salt4king/quadruped/cad/stl/thigh_right.stl

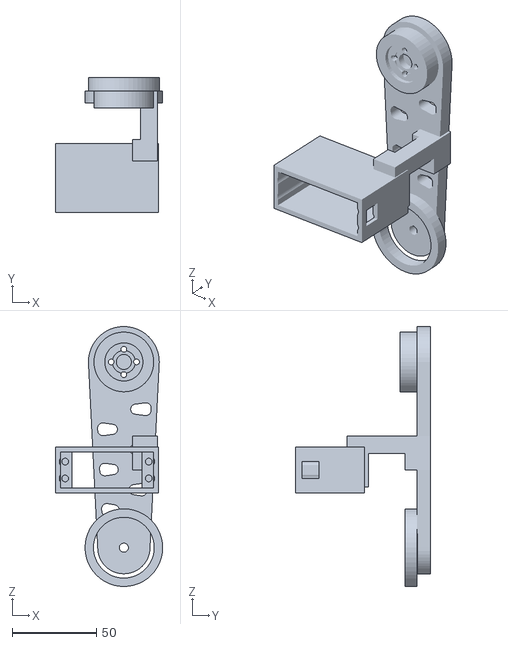
[picture p5: CAD file, 2026-10-24]
cad/stl/thigh_right.stl
63.6 x 80.0 x 154.0
