salt4king/quadruped/cad/web/shank.stl

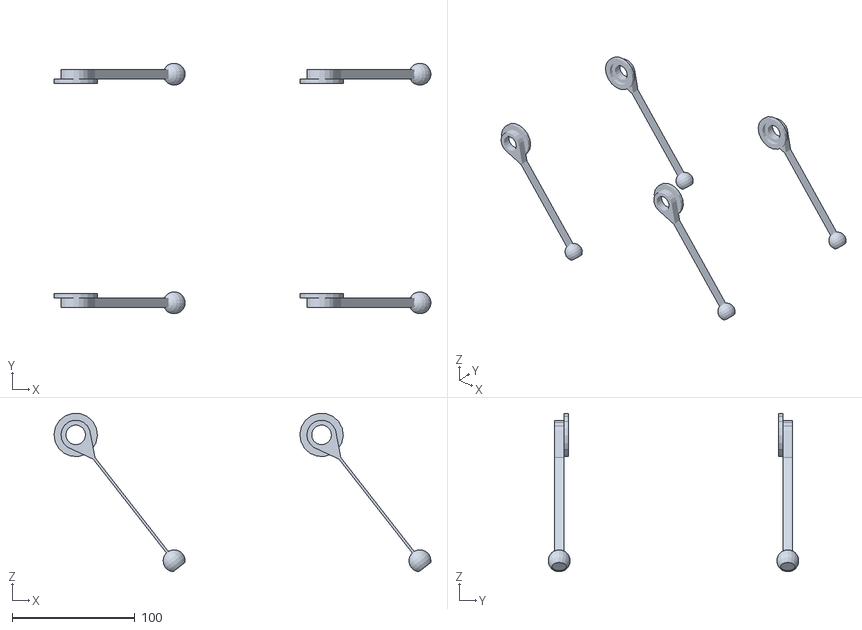
[picture p6: CAD file, 2026-10-21]
cad/web/shank.stl
306.7 x 203.7 x 128.8
