salt4king/quadruped/cad/web/chassis.stl

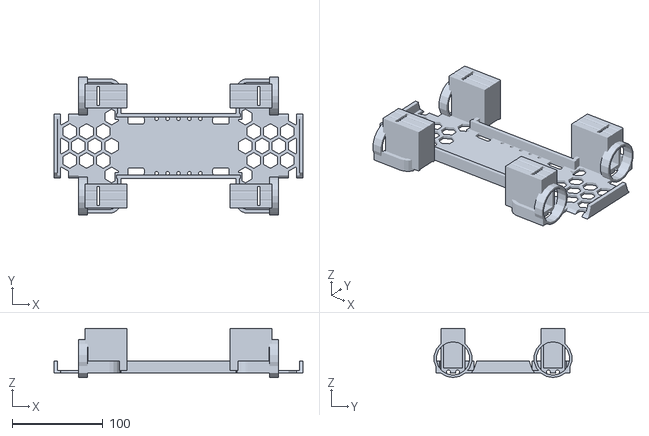
[picture p7: CAD file, 2026-10-21]
cad/web/chassis.stl
274.0 x 151.4 x 54.0
