salt4king/quadruped/cad/stl/shank.stl

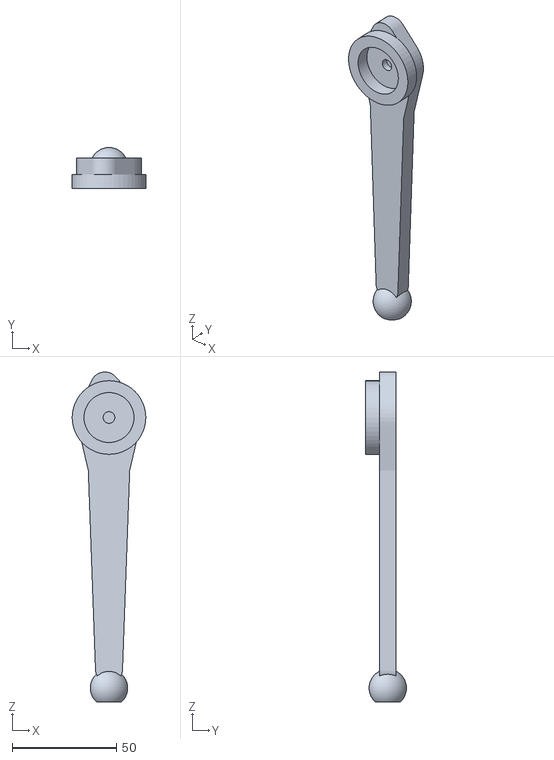
[picture p8: CAD file, 2026-10-21]
cad/stl/shank.stl
35.4 x 19.7 x 158.6
