salt4king/quadruped/cad/web/shoulder.stl

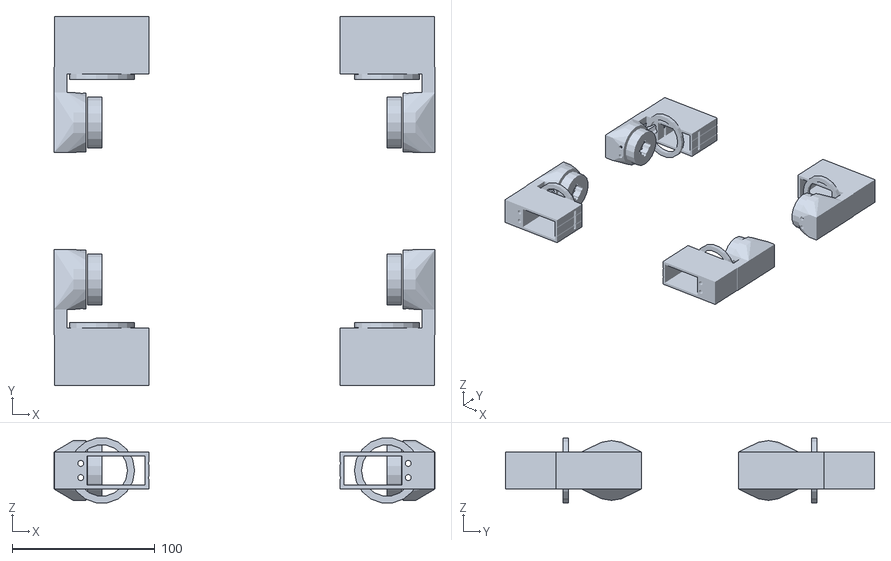
[picture p9: CAD file, 2026-10-21]
cad/web/shoulder.stl
267.0 x 258.8 x 45.3
