salt4king/quadruped/cad/web/servo.stl

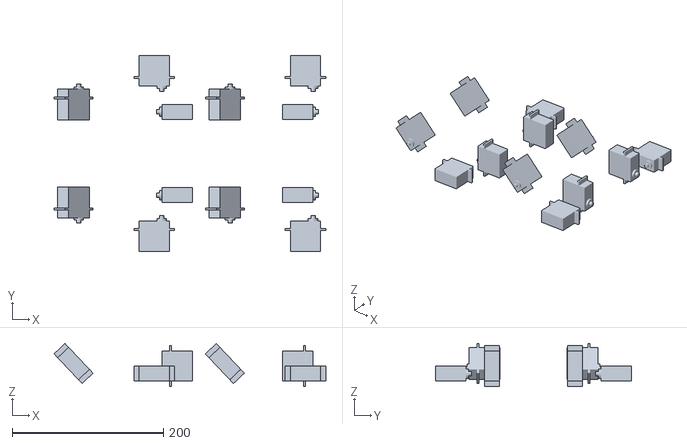
[picture p10: CAD file, 2026-10-21]
cad/web/servo.stl
359.5 x 258.8 x 56.9
