salt4king/quadruped/cad/stl/chassis_front.stl

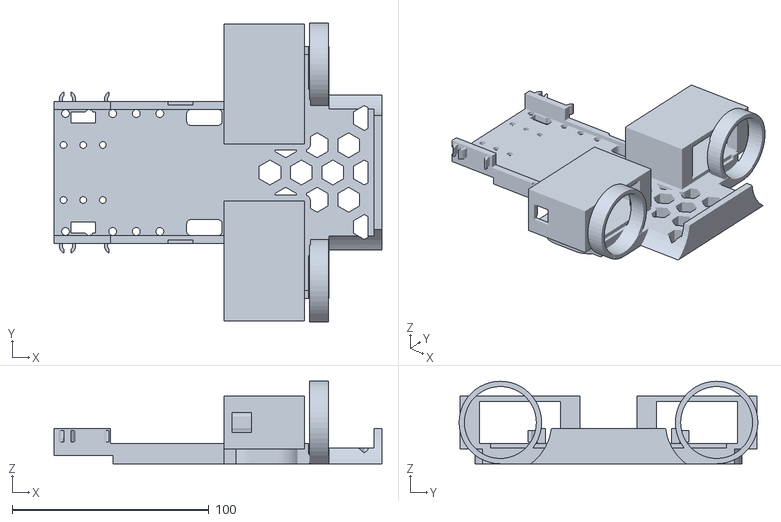
[picture p11: CAD file, 2026-10-21]
cad/stl/chassis_front.stl
166.9 x 152.0 x 42.0
