salt4king/quadruped/cad/web/thigh.stl

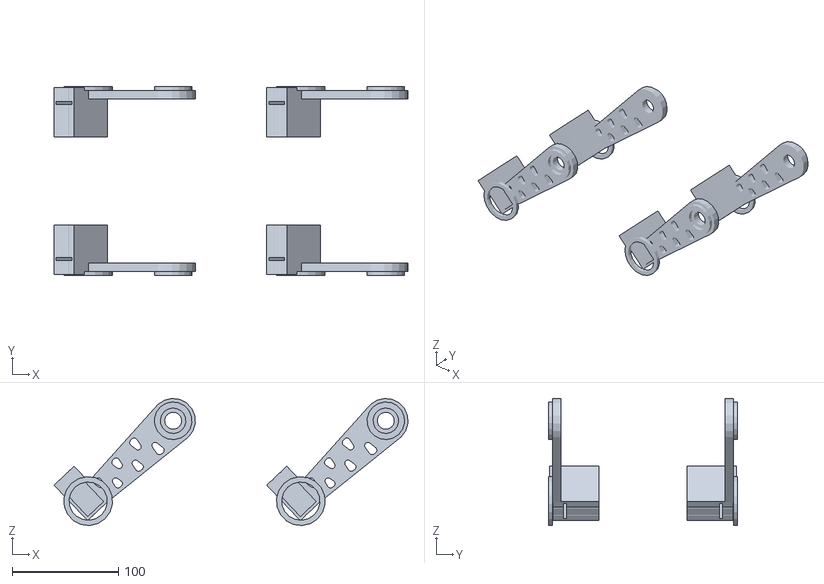
[picture p12: CAD file, 2026-10-21]
cad/web/thigh.stl
332.9 x 178.0 x 119.5
