salt4king/quadruped/cad/stl/insert_test.stl

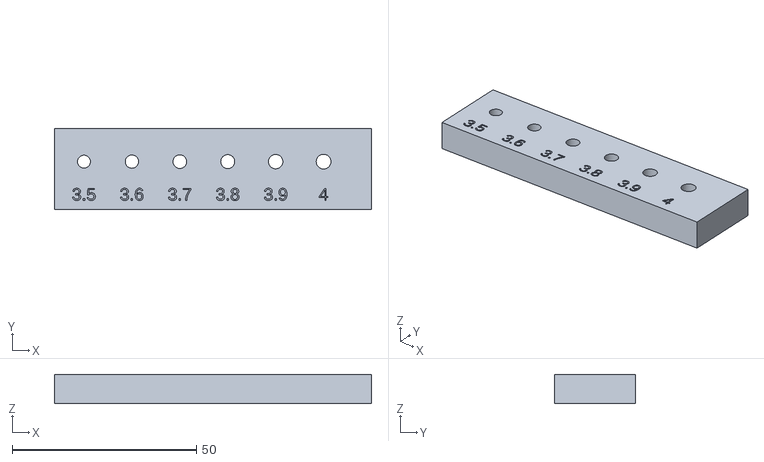
[picture p13: CAD file, 2026-10-21]
cad/stl/insert_test.stl
86.0 x 22.0 x 8.00
