salt4king/quadruped/cad/stl/pushrod.stl

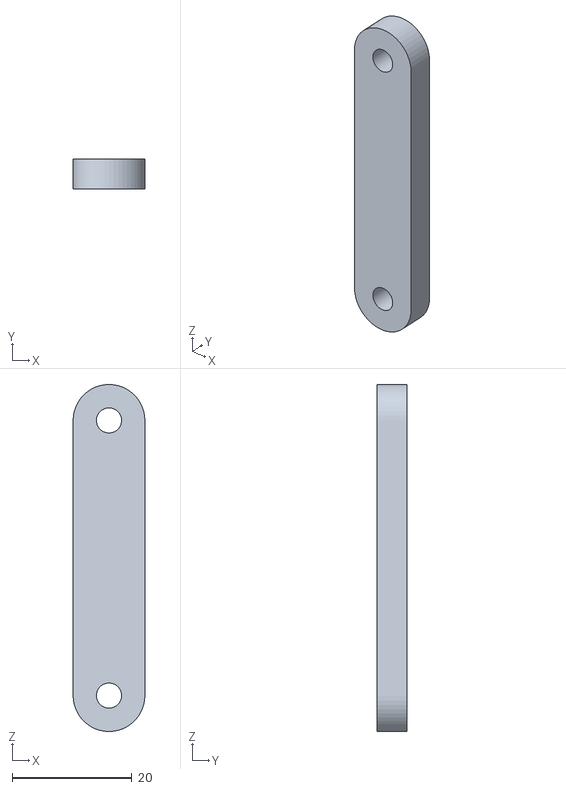
[picture p14: CAD file, 2026-10-21]
cad/stl/pushrod.stl
12.0 x 5.00 x 58.0
