salt4king/quadruped/cad/stl/crank.stl

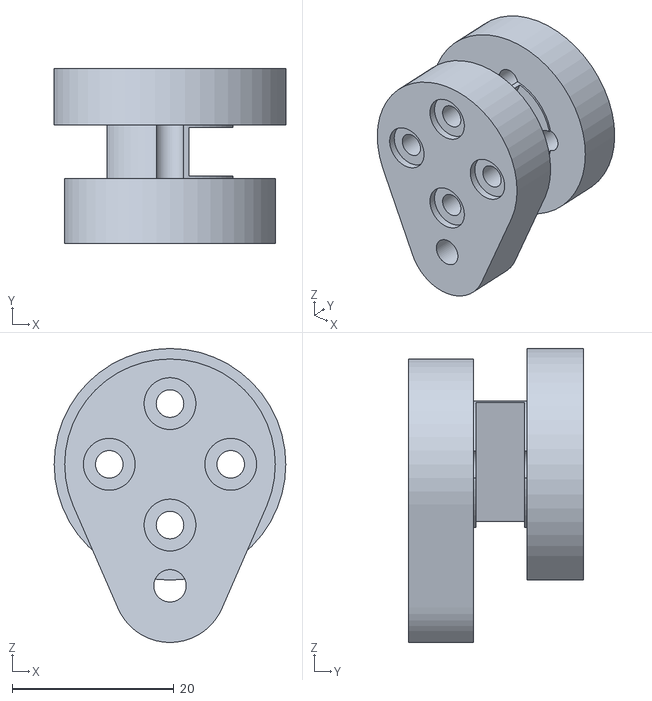
[picture p15: CAD file, 2026-10-21]
cad/stl/crank.stl
28.6 x 21.6 x 36.3
