salt4king/quadruped/cad/stl/roof.stl

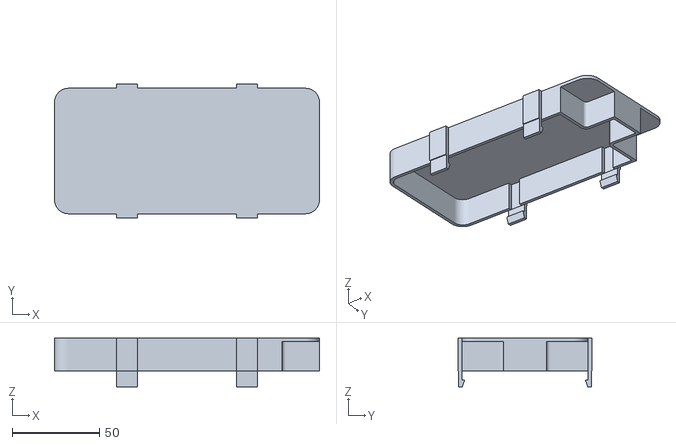
[picture p16: CAD file, 2026-10-21]
cad/stl/roof.stl
152.0 x 77.0 x 28.0
