salt4king/quadruped/cad/stl/chassis.stl

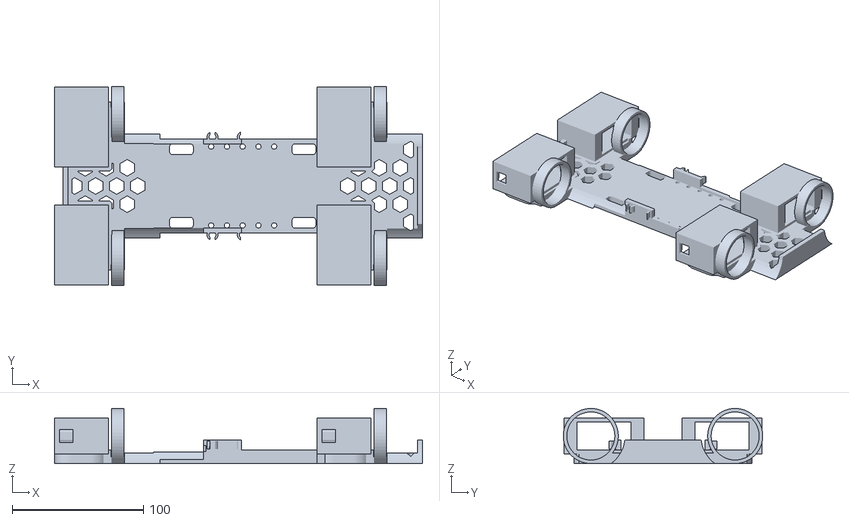
[picture p17: CAD file, 2026-10-21]
cad/stl/chassis.stl
280.4 x 152.0 x 42.0
