salt4king/quadruped/cad/stl/filler.stl

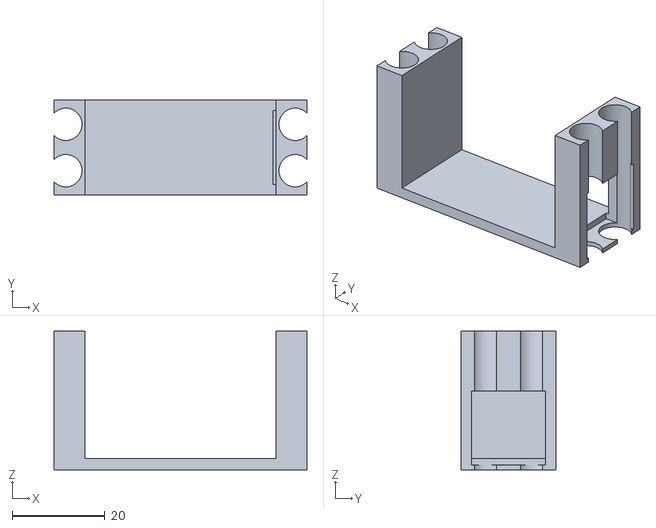
[picture p18: CAD file, 2026-10-21]
cad/stl/filler.stl
54.6 x 20.6 x 29.9
