salt4king/quadruped/cad/stl/chassis_rear.stl

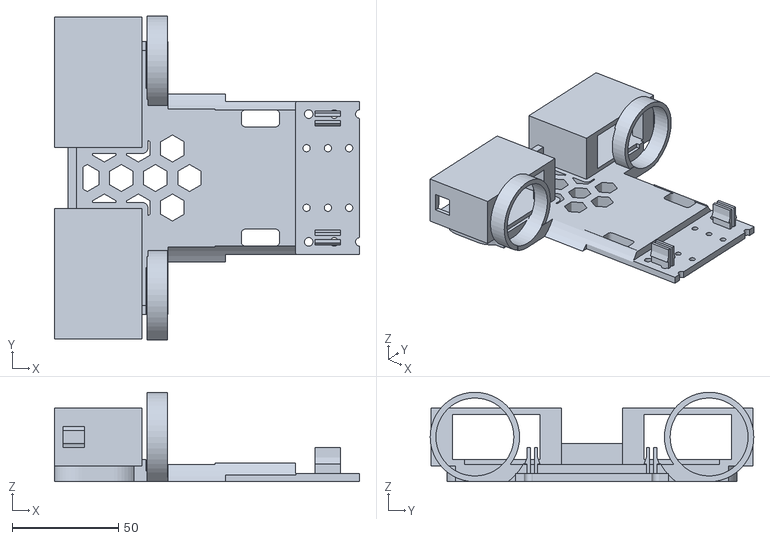
[picture p19: CAD file, 2026-10-21]
cad/stl/chassis_rear.stl
143.2 x 152.0 x 42.0
