salt4king/quadruped/cad/stl/shoulder.stl

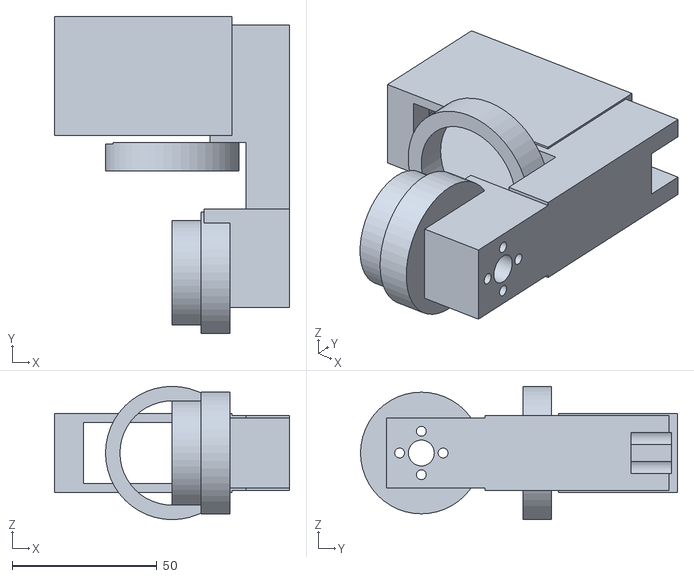
[picture p20: CAD file, 2026-10-21]
cad/stl/shoulder.stl
81.1 x 109.4 x 46.0
