salt4king/quadruped/(list of files, cad)

Other CAD files:
cad/stl/thigh.stl
cad/stl/shank_right.stl
cad/stl/crank_right.stl
