salt4king/quadruped/(commit log)

2026-10-21 Quadruped: mechanics, CAD and the checks that verify them
    A 3D-printed walking robot dog. Twelve DS3225MG servos, direct drive at
    the hip and a parallelogram knee linkage with an exactly 1.0 ratio.
    The CAD is generated from the kinematic model rather than drawn beside
    it: reference/ holds the IK, gait and load solver, and cad/sync_params.py
    emits the dimensions OpenSCAD builds from, so the two cannot disagree
    about a link length.
    Verified rather than eyeballed -- 46 part pairs across 180 poses, servo
    fit and wiring, screw reach, part solidity, wall thickness, bending,
    torsion and journal bearing pressure. Several of those checks exist
    because they caught something: the shank reaching the k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
    [assembly.four-bar.scad, assembly_test.scad, chassis.scad, chassis.stl, chassis_front.stl, chassis_rear.stl, crank.stl, crank_right.stl]
2026-10-21 Shorter docs, better renders
    Re-render the README images from the posed assembly at 4x and downsample:
    contact shadow, linear colour, trimmed framing. Adds a leg close-up.
    Cut CONTROL.md and AI_MODE.md to what you need to start, and trim the
    README to the build path.
2026-10-21 Scaffold firmware/ and host/
    Empty Teensy 4.1 PlatformIO project: build config, a stub per piece, and
    config.h carrying the link lengths, joint limits and rates the CAD was
    built from. Compiles as-is; no logic.
    host/ is a README saying what the web-control side owns.
2026-10-21 Fix the shank's rod pivot, which had no hole
    arm() cut the rocker's M3 hole, then the beam's knee disc was unioned
    on top of it. Same plane, radius 15.5 against a pivot at 15.0, so 77 of
    the hole's 100 cubic millimetres were filled straight back in. It
    printed as a crescent with nothing to screw into.
    Cut the hole after the union instead. No kinematic change -- the pivot
    is still LINK_A from the knee axis.
    Add cad/pivot_test.scad and a second section in check_screws.py that
    probes every linkage pivot against the part as exported. Verified: it
    reports 63 mm3 blocked on the old shank and clear on the new one.
    [leg.scad, pivot_test.scad, shank.stl, shank_right.stl]
2026-10-24 Knee pin: the thigh's hole was 4.5 mm for a 5 mm shoulder
    The build list has always called for an M4 shoulder bolt, 5 mm dia, at
    the knee. The hole in the thigh was M4_CLEAR = 4.5 -- clearance for an
    M4 thread, not for the shoulder that actually passes through it. The
    bolt would not have gone in.
    New KNEE_CLEAR_D = 5.4. Loose on purpose: the bearing is the shank's
    36 mm collar in the thigh's bore, so the pin is only axial retention
    and has nothing to gain from being a fit.
    check_screws now probes the knee pin too, at the shoulder's diameter.
    Verified: 5.6 mm3 blocked on the old thighs, clear on the new ones.
    PARTS.txt says what the joint actually is, and adds the washers that
    take up the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
    [leg.scad, params.scad, pivot_test.scad, thigh.stl, thigh_right.stl]
